michellykaren/embedded-system---automatic-hand-sanitizer-gel-container/README.md

# prototyping_project

Ce code est le résultat d'un projet intitulé Récipient Automatique pour Gel Hydroalcoolique que j'ai réalisé en classe lors du cours Projet Prototypage de ma deuxième année d'études à l'Ecole des Mines de Saint-Etienne, cycle ISMIN. J'ai eu l'occasion d'apprendre sur la modélisation d'une électrode avec le logiciel COMSOL, assemblage et test d'une carte d'oscillateur et la programmation d'un microcontrôleur ST Nucleo-32.

Dans ce dépôt se trouve le projet de code pour programmer une carte STM32F301K8Tx
