michellykaren/embedded-system---automatic-hand-sanitizer-gel-container/Pitch.pdf

# Récipient automatique pour gel hydroalcoolique

Projet Prototypage

Michelly PEREIRA

# Contexte

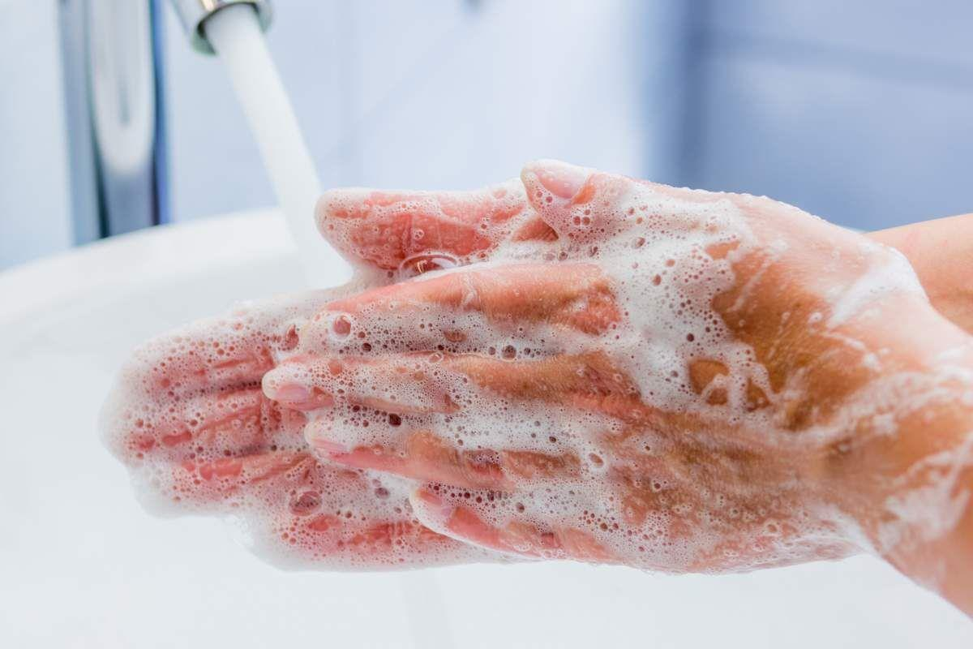
[picture p15: figure]

- 95 % de la population mondiale ne se lave pas fréquemment les mains [OMS]
- 25 % des morts infectieuses pourraient être réduites en développant cette habitude [OMS]
Intoxication alimentaire, diarrhée et pneumonie
- L'utilisation d'un gel hydroalcoolique à 70 % est une façon de minimiser les risques d'infection par le Covid-19 [OMS]

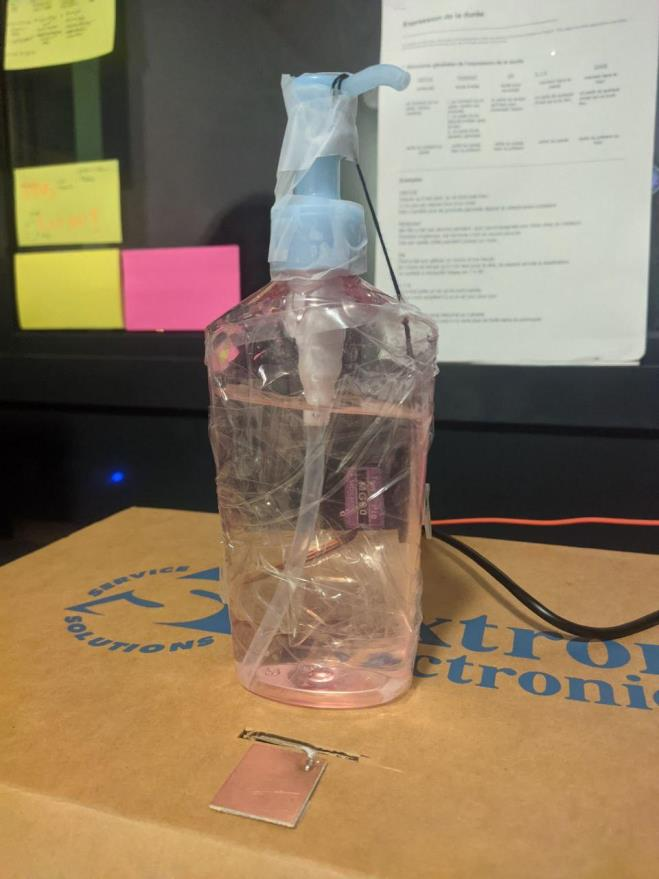
[picture p16: figure]

# Proposition

Récipient | automatique | pour | gel
hydroalcoolique pour stimuler l'hygiène des mains et contrôler la quantité de gel alcoolisé utilisée

# Matériel utilisé

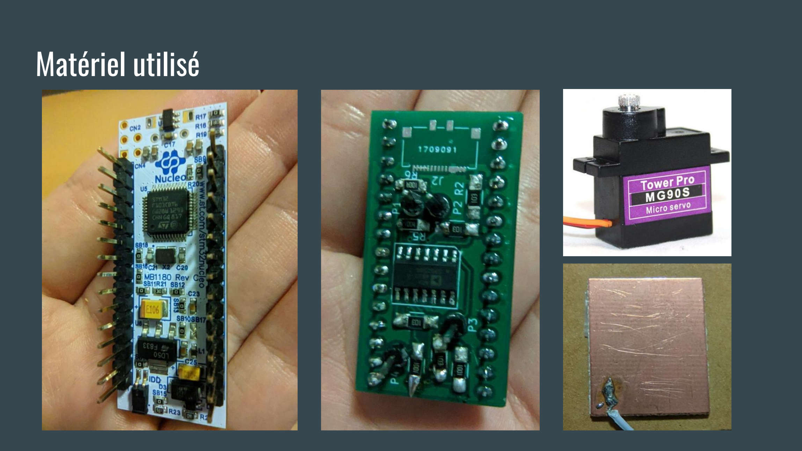
[picture p17: page 4]

# Matériel utilisé

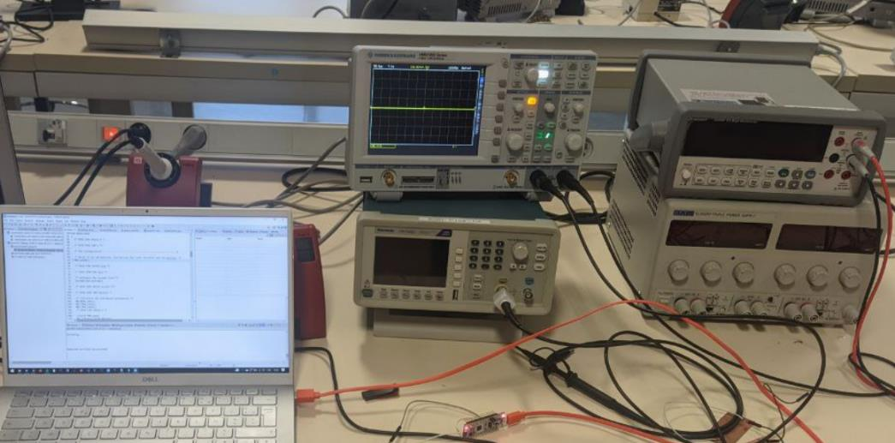
[picture p18: figure]

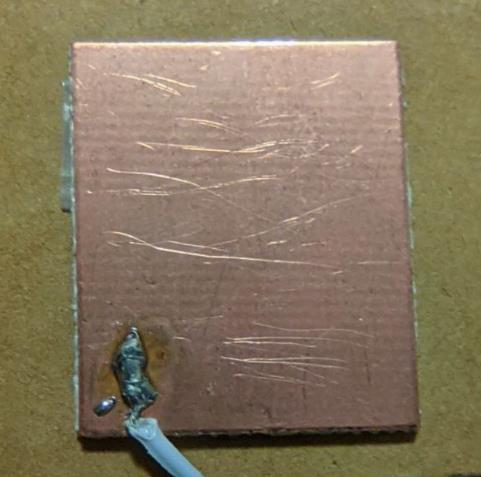
[picture p19: figure]

Une électrode est un élément fondamental dans ce système
Dans ce projet il agit comme un détecteur de proximité de main, éliminant la partie mécanique
La variation de la capacitance est lue et convertie en fréquence
J'ai évité de placer des composants près des électrodes

2.5 cm

3 cm

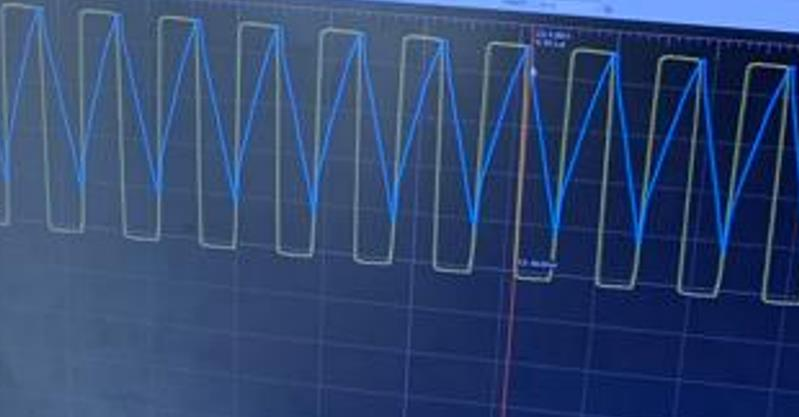
[picture p20: figure]

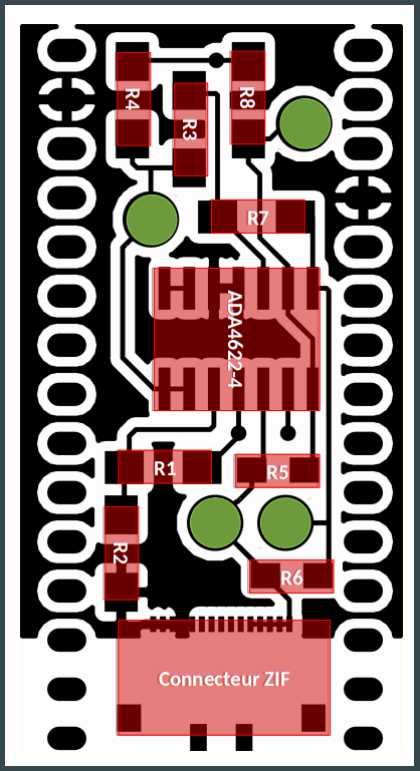
[picture p21: figure]

L’électrode est reliée à un oscillateur dont la fréquence dépend directement de cette capacité

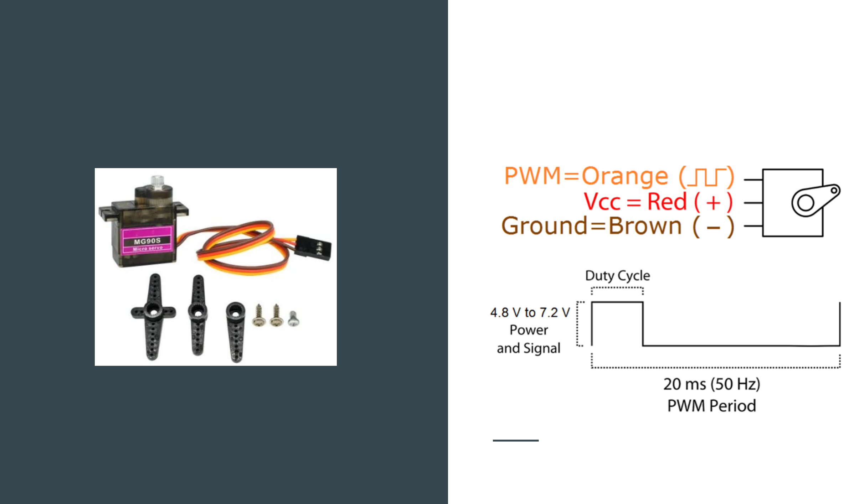
[picture p22: page 8]

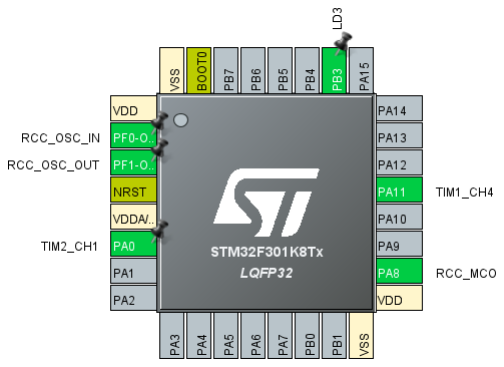
[picture p23: figure]

HAL_TIM_IC_CaptureCallback HAL_TIM_ReadCapturedValue

frequency =
(TIMCLOCK/PSC)/Difference

__HAL_TIM_SET_COMPARE
HAL_Delay

Sans touche | Avec touche

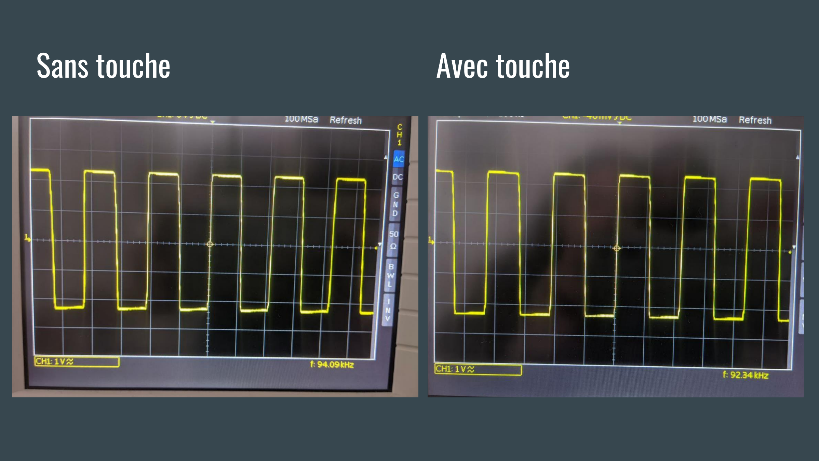
[picture p24: page 10]

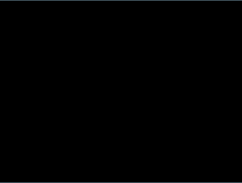
[picture p25: figure]

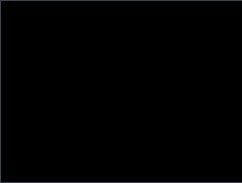
[picture p26: figure]

# Améliorations

# Merci!

michelly.pereira@etu.emse.fr
