michellykaren/embedded-system---automatic-hand-sanitizer-gel-container/protoTD1/Core/Src/main.c

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
/* Includes ------------------------------------------------------------------*/
#include "main.h"

/* USER CODE BEGIN PD */
#define TIMCLOCK   32000000
#define PRESCALAR  1
/* USER CODE END PD */

TIM_HandleTypeDef htim1;
TIM_HandleTypeDef htim2;

/* USER CODE BEGIN PV */

uint32_t IC_Val1 = 0;
uint32_t IC_Val2 = 0;
uint32_t Difference = 0;
int Is_First_Captured = 0;


/* Measure Frequency */
float frequency = 0;

/* USER CODE END PV */

void SystemClock_Config(void);
static void MX_GPIO_Init(void);
static void MX_TIM2_Init(void);
static void MX_TIM1_Init(void);
/* USER CODE BEGIN 0 */
void touner_servo(void);
void HAL_TIM_IC_CaptureCallback(TIM_HandleTypeDef* htim);

/* USER CODE END 0 */

/**
  * @brief  The application entry point.
  * @retval int
  */
int main(void)
{
  /* MCU Configuration--------------------------------------------------------*/

  /* Reset of all peripherals, Initializes the Flash interface and the Systick. */
  HAL_Init();

  /* Configure the system clock */
  SystemClock_Config();

  /* Initialize all configured peripherals */
  MX_GPIO_Init();
  MX_TIM2_Init();
  MX_TIM1_Init();
  /* USER CODE BEGIN 2 */

  //start PWM servo
  HAL_TIM_Base_Start(&htim1);
  HAL_TIM_PWM_Start(&htim1, TIM_CHANNEL_4);

  //start reading frequency
  HAL_TIM_Base_Start(&htim2);
  HAL_TIM_IC_Start_IT(&htim2, TIM_CHANNEL_1);

  /* USER CODE END 2 */

  /* Infinite loop */
  /* USER CODE BEGIN WHILE */
  while(1){

    /* USER CODE END WHILE */

    /* USER CODE BEGIN 3 */
	touner_servo();

  }
  /* USER CODE END 3 */
}

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
/* USER CODE BEGIN 4 */
void touner_servo(void){
	if (frequency > 93000){
		HAL_GPIO_WritePin(GPIOB, LD3_Pin, 0);
		__HAL_TIM_SET_COMPARE(&htim1, TIM_CHANNEL_4, 3200);
		HAL_Delay(100);


	} else if (frequency > 90000 && frequency < 92800){
		HAL_GPIO_WritePin(GPIOB, LD3_Pin, 1);
		__HAL_TIM_SET_COMPARE(&htim1, TIM_CHANNEL_4, 9600);
		HAL_Delay(3200);
	}
}


void HAL_TIM_IC_CaptureCallback(TIM_HandleTypeDef* htim)
{
	if (htim->Channel == HAL_TIM_ACTIVE_CHANNEL_1)
	{
		if (Is_First_Captured==0) // if the first rising edge is not captured
		{
			IC_Val1 = HAL_TIM_ReadCapturedValue(htim, TIM_CHANNEL_1); // read the first value
			Is_First_Captured = 1;  // set the first captured as true
		}

		else   // If the first rising edge is captured, now we will capture the second edge
		{
			IC_Val2 = HAL_TIM_ReadCapturedValue(htim, TIM_CHANNEL_1);  // read second value

			if (IC_Val2 > IC_Val1)
			{
				Difference = IC_Val2-IC_Val1;
				float refClock = TIMCLOCK/(PRESCALAR);

				//frequency = HAL_RCC_GetPCLK1Freq()/Difference;
				frequency = refClock/Difference;

				__HAL_TIM_SET_COUNTER(htim, 0);  // reset the counter
			}
			Is_First_Captured = 0; // set it back to false
		}

	}
}

/* USER CODE END 4 */
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
