michellykaren/embedded-system---automatic-hand-sanitizer-gel-container/protoTD1/protoTD1.ioc

Mcu.UserName=STM32F301K8Tx
PA0.Signal=S_TIM2_CH1_ETR
PA11.Signal=S_TIM1_CH4
PA8.Signal=RCC_MCO
PB3.GPIO_Label=LD3
PB3.Signal=GPIO_Output
PF0-OSC_IN.Signal=RCC_OSC_IN
PF1-OSC_OUT.Signal=RCC_OSC_OUT
